sadbanana303/autonomous-trash-picking-robot/hardware/cad/README.md

CAD files for the picker shaft and ramp hinges, modeled in Fusion 360.
