sadbanana303/autonomous-trash-picking-robot/docs/bill_of_materials.md

# Bill of materials

| Part | Qty | Unit cost | Total |
|:---|:---:|:---:|:---:|
| Raspberry Pi 4B | 1 | 13500 | 13500 |
| BTS7960 motor driver | 3 | 250 | 750 |
| DC motor with wheel | 4 | 750 | 3000 |
| DC motor (picker) | 1 | 560 | 560 |
| HC-SR04 ultrasonic sensor | 3 | 90 | 270 |
| LM2596 buck converter | 1 | 50 | 50 |
| USB webcam | 1 | 500 | 500 |
| Breadboard, resistors, jumper wires | 1 set | 300 | 300 |
| Battery and holder | 1 | 3000 | 3000 |
| Acrylic sheet, cardboard, PVC pipe, zip ties, tape, screws | n/a | 3000 | 3000 |
| 3D-printed parts (shaft coupling, ramp hinges) | 1 set | 300 | 300 |
| **Total** | | | 25,230 |

PRICES IN INR; ALL VALUES ARE APPROXIMATE
