sadbanana303/autonomous-trash-picking-robot/hardware/cad/hinge.picker.stl

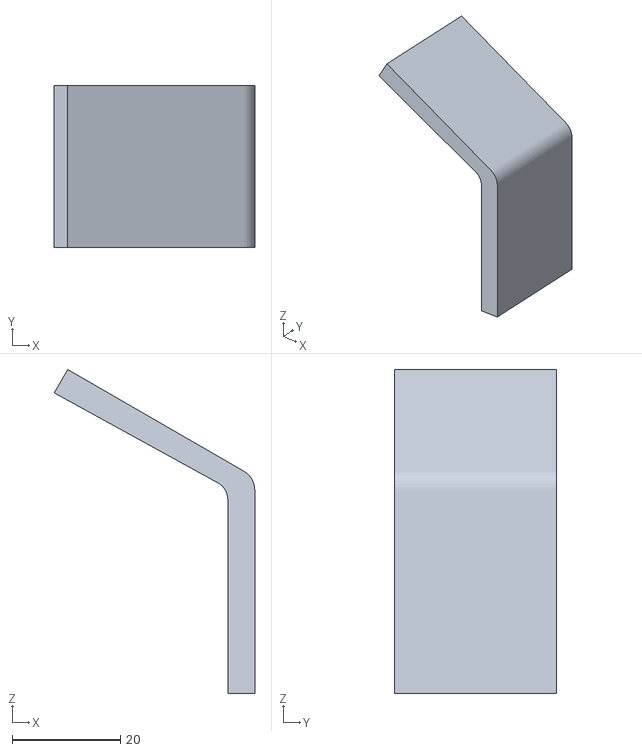
[picture p5: CAD file, 2026-11-07]
hardware/cad/hinge.picker.stl
37.1 x 30.0 x 60.0
