sadbanana303/autonomous-trash-picking-robot/hardware/cad/shaftprint.stl

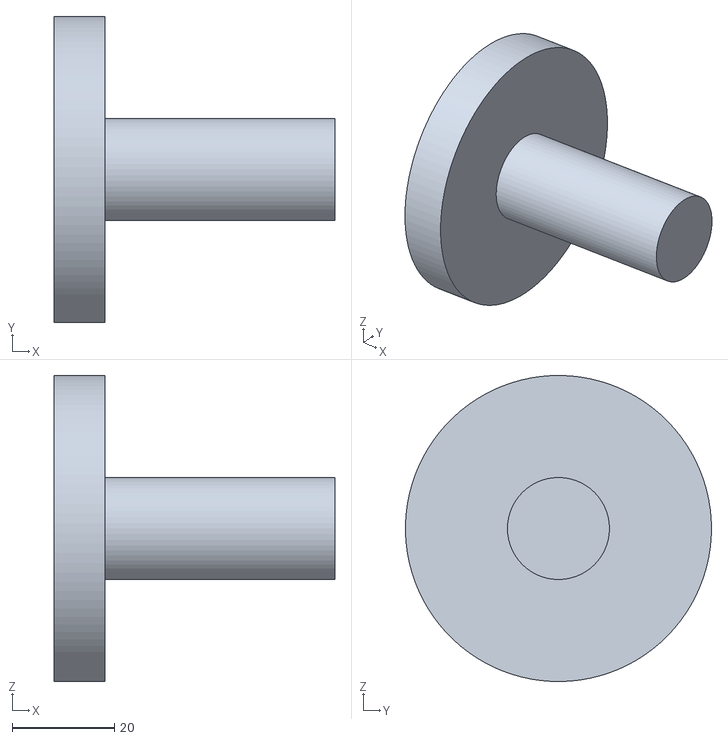
[picture p6: CAD file, 2026-11-07]
hardware/cad/shaftprint.stl
55.0 x 60.0 x 60.0
